vgbn2/BTL-KTVXL-N1/workspace/PROMPT_LOG.md

# Prompt Log

## [2026-10-09T15:35:15.238Z] Session Orchestrator Boot
- Branch: feature/hardware-wiring-and-docs
- Prompt: /session-orchestrator

## [2026-10-10T02:27:55.061Z] Session Orchestrator Boot
- Branch: feature/hardware-wiring-and-docs
- Prompt: /session-orchestrator
