vgbn2/BTL-KTVXL-N1/workspace/handoff/2026/10/2026-10-09.md

# Handoff: 2026-10-09

## Session Summary
- **Accomplishments:**
  1. **Physical Component Alignment:** Cross-checked user's physical order photographs against system models, resolving key physical form-factor discrepancies:
     - W25Q64 Flash module: Modeled as 6-pin breakout board (`[Lập Trình Nhúng A-Z][135]`) with onboard pull-ups on WP# and HOLD#, eliminating unnecessary breadboard jumper wires.
     - ESP32 CH340 DevKit: Updated to 30-Pin Type-C layout, accurately placing UART2 RX2/TX2 (GPIO 16/17) on right header pins 9–10 and VIN on left pin 15.
     - STM32 Blue Pill: Updated to Type-C edition and documented ST-Link V2 SWD programming connection.
     - 2.8" SPI TFT LCD (ILI9341): Re-architected connector as a single contiguous 8-pin straight header matching the physical Red PCB module.
  2. **Automated Verification Probing:** Implemented `scripts/verify_hardware_sim.js` verifying 100% of SVG pin coordinates, dynamic wire net resolutions, and cross-document pin consistency.
  3. **Academic-Grade Engineering Treatise:** Elevated `docs/Hardware_Architecture_and_Wiring_Rationale.md` to an academic-grade report with:
     - Mathematical proof of sampling jitter impact on numerical angle integration ($\sigma_{\delta t} \le 15\text{ }\mu\text{s}$).
     - Analytical proof of display memory ($150\text{ KiB}$) and SPI blocking latency ($61.44\text{ ms}$) demanding dual-MCU partitioning.
     - Signal integrity and rise time calculations for I2C Fast-Mode ($t_r \approx 2.2 R_p C_{\text{bus}}$) and SPI buses (18–40 MHz).
     - Thermal dissipation calculations ($T_J = 46.4^\circ\text{C}$ on ESP32 AMS1117 LDO) and total power budget ($1.17\text{ W}$).
     - Formal FMEA failure matrix with quantitative Risk Priority Numbers (RPN).
  4. **Updated Interactive Studio & Pinouts:** Updated `docs/interactive-wiring.html` and `docs/Wiring_and_Pinouts.md` to achieve 1:1 hardware realism.

- **Files Modified / Created:**
  - `docs/interactive-wiring.html`
  - `docs/Wiring_and_Pinouts.md`
  - `docs/Hardware_Architecture_and_Wiring_Rationale.md`
  - `scripts/verify_hardware_sim.js`
  - `memory/hardware-wiring-architecture.md`
  - `workspace/STATE.md`
  - `workspace/handoff/2026/10/2026-10-09.md`

- **First Next Action:**
  - Implement STM32 bare-metal firmware drivers in `lib/mpu6050` (I2C1 communication, DLPF config, raw reading), `lib/w25qxx` (SPI1 driver, sector erase, write/read calibration data), and Timer ISR (100 Hz Complementary Filter engine).
