vgbn2/BTL-KTVXL-N1/workspace/handoff/2026/10/2026-10-10.md

# Handoff: 2026-10-10

## Session Summary
- **Accomplishments:**
  1. **Documentation Methodology & Predevelopment Package:** Researched the predevelopment research kit and authored the comprehensive 16-section engineering standard in `docs/Project_Predevelopment_Package.md` (967 lines, C4 diagrams, ADRs, state machines, and bidirectional traceability matrix).
  2. **Firmware Core Implementation:** Authored modular C code for sensor fusion (`filter.c`), 15-byte binary telemetry and ASCII command codec (`protocol.c`), W25Q64 Sector 0 serialization with CRC32 (`storage_format.c`), I2C1 MPU6050 driver (`mpu6050.c`), SPI1 flash driver (`w25qxx.c`), and STM32 main loop (`main.c`).
  3. **ESP32 Firmware & Dashboard:** Authored `src/esp32_firmware/esp32_firmware.ino` (ILI9341 320x240 landscape dashboard + UART2 bridge) and verified clean cross-compilation with `arduino-cli`.
  4. **Host Unit Tests & Simulator:** Authored `tests/test_firmware_core.c` and `Makefile`; verified 100% passing tests for filter math, telemetry CRC16, and flash configuration validation.
  5. **Wokwi Simulation Suite:** Created `diagram.json`, `wokwi.toml`, `libraries.txt`, `wokwi_standalone.json`, and standalone 3D interactive simulation sketch `src/esp32_standalone_sim/`.
  6. **Pinout Documentation Enhancement:** Added Section 2.5 ILI9341 2.8" SPI TFT rectangular pinout diagram with left-aligned header pins and right-aligned screen area into `docs/Wiring_and_Pinouts.md`.

- **Verification Evidence:**
  - `make test`: 100% tests passed.
  - `make sim`: STM32 telemetry simulation loop executed cleanly.
  - `arduino-cli compile --fqbn esp32:esp32:esp32 src/esp32_firmware`: 0 errors.
  - `node scripts/verify_hardware_sim.js`: 22 wire nets and 85 pin sockets verified.

- **First Next Action:**
  - Connect physical breadboard wires following `docs/Wiring_and_Pinouts.md`, flash STM32 and ESP32, and execute field calibration.
