vgbn2/BTL-KTVXL-N1/docs/Research/MPU6050.md

# MPU-6050 (GY-521) 6-Axis MotionTracking Module Deep Dive & Register Reference

**Datasheet Reference:** InvenSense *MPU-6000 and MPU-6050 Product Specification*, Document Number `PS-MPU-6000A-00`, Revision 3.4 (08/19/2013).  
**Register Map Reference:** InvenSense *MPU-6000 and MPU-6050 Register Map and Descriptions*, Document Number `RM-MPU-6000A-00`, Revision 4.0 (03/09/2012).  
**Target Hardware:** InvenSense MPU-6050 QFN-24 on GY-521 Breakout Board (Dual Sensor Setup)  
**Target Bus:** Shared I2C1 on STM32F103C8T6 (`PB6` SCL, `PB7` SDA) @ $400\text{ kHz}$ Fast Mode  
**Module Owner (TV1 - Trần Đức Anh):** Driver implementation in `src/lib/drivers/mpu6050.c` & `src/lib/drivers/mpu6050.h`

---

## 1. Physical Pin Layout & Dual-Sensor Hardware Anchoring

### 1.1 GY-521 Breakout Pinout (8-Pin 2.54mm Pitch)

```text
       +-----------------------+
       |   GY-521 (MPU-6050)   |
       |                       |
 [ 1 ] | VCC     (3.3V - 5.0V) | ---> 3.3V System Rail (feeder for onboard LDO)
 [ 2 ] | GND     (0V Ground)   | ---> Common System Ground
 [ 3 ] | SCL     (I2C Clock)   | ---> STM32 PB6 (I2C1_SCL) + 4.7k Pull-up to 3.3V
 [ 4 ] | SDA     (I2C Data)    | ---> STM32 PB7 (I2C1_SDA) + 4.7k Pull-up to 3.3V
 [ 5 ] | XDA     (Aux Data)    | ---> NC (Auxiliary I2C Master pass-through)
 [ 6 ] | XCL     (Aux Clock)   | ---> NC (Auxiliary I2C Master pass-through)
 [ 7 ] | AD0     (Addr Select) | ---> Hardware I2C Address Pin (GND=0x68, 3.3V=0x69)
 [ 8 ] | INT     (Interrupt)   | ---> STM32 EXTI (Optional hardware Data Ready IRQ)
       +-----------------------+
```

### 1.2 Pin Function Descriptions (Datasheet Section 3.2, p. 11)

| Pin | Type | Logic Voltage | Function Description (Datasheet Citations) |
| :--- | :--- | :--- | :--- |
| **`VCC`** | Power Input | $3.3\text{V} - 5.0\text{V}$ | Feeds onboard low-dropout regulator (KB33 / XC6206). Core silicon $V_{\text{DD}}$ operates at $2.375\text{V} - 3.46\text{V}$ (Section 6.3). |
| **`GND`** | Power | $0\text{V}$ | Common system ground return. |
| **`SCL`** | Digital Input | $3.3\text{V}$ | I2C Serial Clock bus. Minimum clock low time $t_{\text{LOW}} \ge 1.3\ \mu\text{s}$, high time $t_{\text{HIGH}} \ge 0.6\ \mu\text{s}$ at $400\text{ kHz}$ Fast Mode (Table 6.4, p. 17). |
| **`SDA`** | Digital I/O | $3.3\text{V}$ (Open-Drain) | I2C Serial Data bus. Requires external $4.7\text{k}\Omega$ pull-up resistor to 3.3V. |
| **`XDA`** | Digital I/O | $3.3\text{V}$ | Auxiliary I2C Master Data line for secondary sensor pass-through (e.g. 3-axis magnetometer HMC5883L / AK8975). |
| **`XCL`** | Digital Output| $3.3\text{V}$ | Auxiliary I2C Master Clock line. |
| **`AD0`** | Digital Input | $0\text{V} - 3.3\text{V}$ | **I2C Address Select (Section 7.5.1):** When tied to GND, 7-bit slave address is `0x68` (`0b1101000`). When tied to 3.3V ($V_{\text{LOGIC}}$), slave address is `0x69` (`0b1101001`). |
| **`INT`** | Digital Output| $3.3\text{V}$ | Programmable interrupt output (Push-pull or Open-drain, Active High or Active Low via `INT_PIN_CFG`). Asserted on Data Ready or Motion Threshold. |

### 1.3 Dual-MPU6050 Hardware Bus Anchoring on Single I2C1

The project utilizes two independent MPU-6050 sensors on the same physical I2C1 bus (`PB6` SCL, `PB7` SDA) without multiplexer hardware:
- **MPU 1 (Primary / Reference IMU):** `AD0` pin soldered to **GND** $\rightarrow$ 7-bit Address = `0x68` (Write: `0xD0`, Read: `0xD1`).
- **MPU 2 (Secondary / Redundancy IMU):** `AD0` pin soldered to **3.3V** $\rightarrow$ 7-bit Address = `0x69` (Write: `0xD2`, Read: `0xD3`).

```text
STM32F103 (I2C1)                   MPU6050 #1 (0x68)              MPU6050 #2 (0x69)
+---------------+                  +---------------+              +---------------+
|               |                  |               |              |               |
|  PB6 (SCL) ---+---+--------------+ SCL           |  +-----------+ SCL           |
|               |   |              |               |  |           |               |
|  PB7 (SDA) ---+---+---+----------+ SDA           |  |  +--------+ SDA           |
|               |   |   |          |               |  |  |        |               |
|  3.3V Rail ---+---|---+--[4.7k]--+ VCC           |  |  |  +-----+ VCC           |
|               |   |   +--[4.7k]--+               |  |  |  |     |               |
|  GND Rail ----+---|--------------+ GND           |  |  |  |     | GND           |
|               |   |              | AD0 ---- GND  |  |  |  |     | AD0 ---- 3.3V |
+---------------+   |              +---------------+  |  |  |     +---------------+
                    |                                 |  |  |
                    +---------------------------------+--+--+
```

---

## 2. Sensor Electrical & Physical Measurement Characteristics

### 2.1 Accelerometer Specifications (Datasheet Table 6.2, p. 14)

| Parameter | Condition | Min | Typical | Max | Unit |
| :--- | :--- | :---: | :---: | :---: | :---: |
| **Full-Scale Range ($AFS\_SEL$)** | Configured via `ACCEL_CONFIG` (Reg 28 / 0x1C) | $\pm 2$, $\pm 4$, $\pm 8$, $\pm 16$ | — | $g$ |
| **Sensitivity Scale Factor** | $\pm 2g$ Range (`AFS_SEL = 0`, Default) | — | **`16,384`** | — | **LSB / g** |
| | $\pm 4g$ Range (`AFS_SEL = 1`) | — | `8,192` | — | LSB / g |
| | $\pm 8g$ Range (`AFS_SEL = 2`) | — | `4,096` | — | LSB / g |
| | $\pm 16g$ Range (`AFS_SEL = 3`) | — | `2,048` | — | LSB / g |
| **Initial Tolerance** | Factory calibration @ $25^\circ\text{C}$ | — | $\pm 50$ | — | mg |
| **Zero-g Output** | X and Y axis | — | $\pm 50$ | — | mg |
| | Z axis (including gravity) | — | $\pm 80$ | — | mg |
| **Non-Linearity** | Best fit straight line | — | $\pm 0.5$ | — | % |
| **Cross-Axis Sensitivity** | Cross-axis alignment | — | $\pm 2$ | — | % |
| **Noise Power Spectral Density** | Low noise mode @ 10 Hz | — | $400$ | — | $\mu g / \sqrt{\text{Hz}}$ |

### 2.2 Gyroscope Specifications (Datasheet Table 6.1, p. 13)

| Parameter | Condition | Min | Typical | Max | Unit |
| :--- | :--- | :---: | :---: | :---: | :---: |
| **Full-Scale Range ($FS\_SEL$)** | Configured via `GYRO_CONFIG` (Reg 27 / 0x1B) | $\pm 250$, $\pm 500$, $\pm 1000$, $\pm 2000$ | — | $^\circ/\text{s}$ (dps) |
| **Sensitivity Scale Factor** | $\pm 250^\circ/\text{s}$ Range (`FS_SEL = 0`, Default) | — | **`131.0`** | — | **LSB / (dps)** |
| | $\pm 500^\circ/\text{s}$ Range (`FS_SEL = 1`) | — | `65.5` | — | LSB / (dps) |
| | $\pm 1000^\circ/\text{s}$ Range (`FS_SEL = 2`) | — | `32.8` | — | LSB / (dps) |
| | $\pm 2000^\circ/\text{s}$ Range (`FS_SEL = 3`) | — | `16.4` | — | LSB / (dps) |
| **Zero-Rate Output (ZRO)** | $25^\circ\text{C}$, stationary | — | $\pm 20$ | — | $^\circ/\text{s}$ |
| **Total RMS Noise** | DLPF = 42 Hz | — | $0.05$ | — | $^\circ/\text{s-rms}$ |
| **Non-Linearity** | Best fit straight line | — | $0.2$ | — | % |

---

## 3. Register Map and Bitfield Definitions (Extracted from RM-MPU-6000A Rev 4.0)

All internal registers are memory-mapped 8-bit locations accessible via I2C read and write operations.

### 3.1 Primary Register Table (Section 3, pp. 6–8)

| Reg (Hex) | Reg (Dec) | Register Name | R/W | Bitfield Layout | Reset Val | Function Description |
| :---: | :---: | :--- | :---: | :--- | :---: | :--- |
| **`0x19`** | 25 | `SMPLRT_DIV` | R/W | `SMPLRT_DIV[7:0]` | `0x00` | Sample Rate Divider: $\text{Rate} = \frac{\text{Gyro Output Rate}}{1 + \text{SMPLRT\_DIV}}$. |
| **`0x1A`** | 26 | `CONFIG` | R/W | `-[7:6], EXT_SYNC_SET[5:3], DLPF_CFG[2:0]` | `0x00` | Digital Low Pass Filter and external FSYNC configuration. |
| **`0x1B`** | 27 | `GYRO_CONFIG` | R/W | `XG_ST[7], YG_ST[6], ZG_ST[5], FS_SEL[4:3], -[2:0]` | `0x00` | Gyroscope self-test enable and full-scale range select. |
| **`0x1C`** | 28 | `ACCEL_CONFIG` | R/W | `XA_ST[7], YA_ST[6], ZA_ST[5], AFS_SEL[4:3], -[2:0]` | `0x00` | Accelerometer self-test enable and full-scale range select. |
| **`0x23`** | 35 | `FIFO_EN` | R/W | `TEMP_FIFO_EN[7], XG_FIFO_EN[6], YG_FIFO_EN[5], ZG_FIFO_EN[4], ACCEL_FIFO_EN[3], SLV2_FIFO_EN[2], SLV1_FIFO_EN[1], SLV0_FIFO_EN[0]` | `0x00` | Enables routing of sensor data into the 1024-byte FIFO buffer. |
| **`0x37`** | 55 | `INT_PIN_CFG` | R/W | `INT_LEVEL[7], INT_OPEN[6], LATCH_INT_EN[5], INT_RD_CLEAR[4], FSYNC_INT_LEVEL[3], FSYNC_INT_EN[2], I2C_BYPASS_EN[1], -[0]` | `0x00` | Interrupt pin active level, open-drain/push-pull, latching, and I2C bypass. |
| **`0x38`** | 56 | `INT_ENABLE` | R/W | `-[7:5], FIFO_OFLOW_EN[4], I2C_MST_INT_EN[3], -[2:1], DATA_RDY_EN[0]` | `0x00` | Interrupt source generation enables (`DATA_RDY_EN = 1` enables Data Ready). |
| **`0x3A`** | 58 | `INT_STATUS` | R | `-[7:5], FIFO_OFLOW_INT[4], I2C_MST_INT[3], -[2:1], DATA_RDY_INT[0]` | `0x00` | Interrupt status bits (cleared automatically upon reading). |
| **`0x3B`** | 59 | `ACCEL_XOUT_H` | R | `ACCEL_X[15:8]` | Data | Accelerometer X-axis measurement high byte (Start of 14-byte burst read). |
| **`0x3C`** | 60 | `ACCEL_XOUT_L` | R | `ACCEL_X[7:0]` | Data | Accelerometer X-axis measurement low byte. |
| **`0x3D`** | 61 | `ACCEL_YOUT_H` | R | `ACCEL_Y[15:8]` | Data | Accelerometer Y-axis measurement high byte. |
| **`0x3E`** | 62 | `ACCEL_YOUT_L` | R | `ACCEL_Y[7:0]` | Data | Accelerometer Y-axis measurement low byte. |
| **`0x3F`** | 63 | `ACCEL_ZOUT_H` | R | `ACCEL_Z[15:8]` | Data | Accelerometer Z-axis measurement high byte. |
| **`0x40`** | 64 | `ACCEL_ZOUT_L` | R | `ACCEL_Z[7:0]` | Data | Accelerometer Z-axis measurement low byte. |
| **`0x41`** | 65 | `TEMP_OUT_H` | R | `TEMP[15:8]` | Data | Temperature sensor measurement high byte. |
| **`0x42`** | 66 | `TEMP_OUT_L` | R | `TEMP[7:0]` | Data | Temperature sensor measurement low byte ($T = \frac{\text{Raw}}{340} + 36.53$). |
| **`0x43`** | 67 | `GYRO_XOUT_H` | R | `GYRO_X[15:8]` | Data | Gyroscope X-axis measurement high byte. |
| **`0x44`** | 68 | `GYRO_XOUT_L` | R | `GYRO_X[7:0]` | Data | Gyroscope X-axis measurement low byte. |
| **`0x45`** | 69 | `GYRO_YOUT_H` | R | `GYRO_Y[15:8]` | Data | Gyroscope Y-axis measurement high byte. |
| **`0x46`** | 70 | `GYRO_YOUT_L` | R | `GYRO_Y[7:0]` | Data | Gyroscope Y-axis measurement low byte. |
| **`0x47`** | 71 | `GYRO_ZOUT_H` | R | `GYRO_Z[15:8]` | Data | Gyroscope Z-axis measurement high byte. |
| **`0x48`** | 72 | `GYRO_ZOUT_L` | R | `GYRO_Z[7:0]` | Data | Gyroscope Z-axis measurement low byte (End of 14-byte burst read). |
| **`0x6A`** | 106 | `USER_CTRL` | R/W | `-[7], FIFO_EN[6], I2C_MST_EN[5], I2C_IF_DIS[4], -[3], FIFO_RESET[2], I2C_MST_RESET[1], SIG_COND_RESET[0]` | `0x00` | Enable/reset FIFO, secondary I2C master, and signal conditioning blocks. |
| **`0x6B`** | 107 | `PWR_MGMT_1` | R/W | `DEVICE_RESET[7], SLEEP[6], CYCLE[5], -[4], TEMP_DIS[3], CLKSEL[2:0]` | **`0x40`** | **Silicon boots in SLEEP (`0x40`). Must write `0x01` to wake and select PLL clock.** |
| **`0x6C`** | 108 | `PWR_MGMT_2` | R/W | `LP_WAKE_CTRL[7:6], STBY_XA[5], STBY_YA[4], STBY_ZA[3], STBY_XG[2], STBY_YG[1], STBY_ZG[0]` | `0x00` | Low-power accelerometer wake frequency and individual axis standby control. |
| **`0x72`** | 114 | `FIFO_COUNTH` | R | `FIFO_COUNT[15:8]` | `0x00` | Current number of bytes written in FIFO (High byte). |
| **`0x73`** | 115 | `FIFO_COUNTL` | R | `FIFO_COUNT[7:0]` | `0x00` | Current number of bytes written in FIFO (Low byte). |
| **`0x74`** | 116 | `FIFO_R_W` | R/W | `FIFO_DATA[7:0]` | `0x00` | FIFO read/write port. |
| **`0x75`** | 117 | `WHO_AM_I` | R | `-[7], WHO_AM_I[6:1], -[0]` | **`0x68`** | Silicon 6-bit identity verification. Must equal `0x68` (or `0x70` for MPU-6500). |

---

## 4. Deep-Dive Extraction of Key Functional Registers

### 4.1 Sample Rate Calculation & SMPLRT_DIV (Section 4.2, p. 11)

The internal sensor sample rate is configured via Register 25 (`0x19`):

$$\text{Sample Rate} = \frac{\text{Gyroscope Output Rate}}{1 + \text{SMPLRT\_DIV}}$$

- When DLPF is **disabled** (`DLPF_CFG = 0` or `7` in Register 26): Gyroscope Output Rate = **$8\text{ kHz}$**.
- When DLPF is **enabled** (`DLPF_CFG = 1` through `6`): Gyroscope Output Rate = **$1\text{ kHz}$**.

**Project Timing Anchor:**  
With DLPF configured to `0x03` ($1\text{ kHz}$ base rate):
- Setting `SMPLRT_DIV = 0x09` ($9_{\text{dec}}$) yields:
  $$\text{Sample Rate} = \frac{1000\text{ Hz}}{1 + 9} = 100\text{ Hz}\quad (10.0\text{ ms period})$$
  This precisely synchronizes with the system timer interrupt defined in `docs/QUY_TAC_CODE_NHOM_MPU6050.md` (`IMU_SAMPLE_RATE_HZ = 100`, $dt = 0.01\text{ s}$).
- Setting `SMPLRT_DIV = 0x19` ($25_{\text{dec}}$) yields:
  $$\text{Sample Rate} = \frac{1000\text{ Hz}}{1 + 25} \approx 38.46\text{ Hz}$$

---

### 4.2 Digital Low Pass Filter (DLPF_CFG) Mechanics (Section 4.3, p. 13)

Register 26 (`0x1A` / `CONFIG`) bits `[2:0]` configure the on-chip analog-to-digital converter (ADC) digital filter pipeline for both Accelerometer and Gyroscope signals:

| DLPF_CFG | Accelerometer Bandwidth (Hz) | Accelerometer Delay (ms) | Gyroscope Bandwidth (Hz) | Gyroscope Delay (ms) | Fs (kHz) |
| :---: | :---: | :---: | :---: | :---: | :---: |
| **`0`** | 260 | 0.0 | 256 | 0.98 | 8 |
| **`1`** | 184 | 2.0 | 188 | 1.9 | 1 |
| **`2`** | 94 | 3.0 | 98 | 2.8 | 1 |
| **`3`** | **44** | **4.9** | **42** | **4.8** | **1** |
| **`4`** | 21 | 8.5 | 20 | 8.3 | 1 |
| **`5`** | 10 | 13.8 | 10 | 13.4 | 1 |
| **`6`** | 5 | 19.0 | 5 | 18.6 | 1 |
| **`7`** | RESERVED | RESERVED | RESERVED | RESERVED | 8 |

**Design Choice (`DLPF_CFG = 0x03`):**  
Bandwidth of $44\text{ Hz}$ on accelerometer and $42\text{ Hz}$ on gyroscope attenuates high-frequency motor vibration and chassis resonance (>50 Hz) while introducing only $\approx 4.8\text{ ms}$ of group delay, well within our $10\text{ ms}$ ($100\text{ Hz}$) control loop deadline.

---

### 4.3 Full-Scale Range Configuration (GYRO_CONFIG & ACCEL_CONFIG)

#### Gyroscope Full-Scale Selection (`FS_SEL`, Section 4.4, p. 14)

Register 27 (`0x1B`): bits `[4:3]` configure full-scale sensitivity:

| FS_SEL[1:0] | Full-Scale Range | Sensitivity Scale Factor | LSB Sensitivity |
| :---: | :---: | :---: | :---: |
| **`0` (`0x00`)** | **$\pm 250^\circ/\text{s}$** | **$131.0\text{ LSB} / (^\circ/\text{s})$** | **$0.007633^\circ/\text{s} / \text{LSB}$** |
| **`1` (`0x08`)** | $\pm 500^\circ/\text{s}$ | $65.5\text{ LSB} / (^\circ/\text{s})$ | $0.015267^\circ/\text{s} / \text{LSB}$ |
| **`2` (`0x10`)** | $\pm 1000^\circ/\text{s}$ | $32.8\text{ LSB} / (^\circ/\text{s})$ | $0.030488^\circ/\text{s} / \text{LSB}$ |
| **`3` (`0x18`)** | $\pm 2000^\circ/\text{s}$ | $16.4\text{ LSB} / (^\circ/\text{s})$ | $0.060976^\circ/\text{s} / \text{LSB}$ |

#### Accelerometer Full-Scale Selection (`AFS_SEL`, Section 4.5, p. 15)

Register 28 (`0x1C`): bits `[4:3]` configure full-scale sensitivity:

| AFS_SEL[1:0] | Full-Scale Range | Sensitivity Scale Factor | LSB Sensitivity |
| :---: | :---: | :---: | :---: |
| **`0` (`0x00`)** | **$\pm 2g$** | **$16,384\text{ LSB} / g$** | **$0.061035\text{ mg} / \text{LSB}$** |
| **`1` (`0x08`)** | $\pm 4g$ | $8,192\text{ LSB} / g$ | $0.122070\text{ mg} / \text{LSB}$ |
| **`2` (`0x10`)** | $\pm 8g$ | $4,096\text{ LSB} / g$ | $0.244141\text{ mg} / \text{LSB}$ |
| **`3` (`0x18`)** | $\pm 16g$ | $2,048\text{ LSB} / g$ | $0.488281\text{ mg} / \text{LSB}$ |

---

### 4.4 Shadow Registers & Atomic 14-Byte Burst Read Mechanism (Section 4.18, p. 30)

A critical architectural feature detailed in Section 4.18 of `RM-MPU-6000A` is the **User-Facing Read Buffer** (shadow register architecture):

```text
+---------------------------------------------------------------------------------+
|                       INTERNAL SENSOR SAMPLE PIPELINE                            |
|  [ADC / DLPF Engine] ---> Updates Internal Holding Registers @ Sample Rate (1kHz) |
+---------------------------------------------------------------------------------+
                                        |
                 Updated only when I2C bus is IDLE or at START condition
                                        v
+---------------------------------------------------------------------------------+
|                       USER-FACING SHADOW REGISTERS                               |
|  0x3B (ACCEL_X_H) .. 0x40 (ACCEL_Z_L) | 0x41..0x42 (TEMP) | 0x43..0x48 (GYRO_Z_L)|
+---------------------------------------------------------------------------------+
                                        ^
                                        | Read atomically via I2C Auto-Increment
+---------------------------------------------------------------------------------+
| STM32 Master: Single 14-Byte Burst Read Transaction starting at Reg 0x3B         |
+---------------------------------------------------------------------------------+
```

**Hardware Invariant:**  
> *"The most recent record is stored in a set of registers which are user-facing read registers. These registers are updated with the value of the internal registers when the serial interface is idle. If the user reads an accelerometer data register and that data register is subsequently updated with new data, the read value will not be affected."* (RM-MPU-6000A Section 4.18)

**Why Individual Byte Reads Fail:**  
If a driver reads high byte `ACCEL_XOUT_H` and low byte `ACCEL_XOUT_L` in separate I2C transactions, an internal ADC sample clock edge occurring between the two reads can cause MSB/LSB tearing (e.g., transition from `0x00FF` to `0x0100` read as `0x0000` or `0x01FF`).  
**Driver Implementation Rule:**  
Always issue an atomic 14-byte sequential burst read starting at register `0x3B`:
```c
uint8_t raw[14];
HAL_I2C_Mem_Read(&hi2c1, (dev_addr << 1), 0x3B, 1, raw, 14, 50);
```

---

### 4.5 Temperature Sensor Formula & Characteristics (Section 4.19, p. 31)

Registers 65 and 66 (`0x41` and `0x42`) provide a 16-bit signed measurement of silicon die temperature.

#### Transfer Function:

$$\text{Temperature in } ^\circ\text{C} = \frac{\text{TEMP\_OUT}}{340} + 36.53$$

- **Zero-Reading Point:** $\text{TEMP\_OUT} = 0 \implies T = 36.53^\circ\text{C}$.
- **Sensitivity:** $340\text{ LSB} / ^\circ\text{C}$.
- **Linear Range:** $-40^\circ\text{C} \text{ to } +85^\circ\text{C}$.

---

### 4.6 Power Management 1 & Clock Selection (Section 4.30, p. 41)

Register 107 (`0x6B` / `PWR_MGMT_1`):

| Bit | Bit Name | Reset | Description |
| :---: | :--- | :---: | :--- |
| **7** | `DEVICE_RESET` | 0 | Writing `1` resets all internal registers to default. Self-clearing bit. |
| **6** | `SLEEP` | **1** | Silicon boots into low-power sleep mode by default (`0x40`). Must write `0` to wake! |
| **5** | `CYCLE` | 0 | Cycle mode: sleeps and wakes up at rate set by `LP_WAKE_CTRL`. |
| **4** | Reserved | 0 | Reserved. |
| **3** | `TEMP_DIS` | 0 | Writing `1` disables the internal temperature sensor. |
| **[2:0]**| `CLKSEL[2:0]` | 000 | Clock source selection (see table below). |

#### Clock Source Selection Table (`CLKSEL`):

| CLKSEL | Clock Source Description | Recommended Usage |
| :---: | :--- | :--- |
| **`0`** | Internal 8 MHz oscillator | Default at boot; prone to thermal drift ($\pm 5\%$). |
| **`1`** | **PLL with X-axis gyroscope reference** | **Highly Recommended:** Ultra-stable crystal-derived gyro clock. |
| **`2`** | PLL with Y-axis gyroscope reference | Stable crystal reference. |
| **`3`** | PLL with Z-axis gyroscope reference | Stable crystal reference. |
| **`4`** | PLL with external 32.768 kHz reference | Requires external clock source on CLKIN pin. |
| **`5`** | PLL with external 19.2 MHz reference | Requires external clock source on CLKIN pin. |
| **`6`** | Reserved | Do not use. |
| **`7`** | Stops clock generator (Reset state) | Timing generator held in reset. |

**Bring-Up Invariant:**  
Always write `0x01` to `PWR_MGMT_1` during initialization: wakes the chip from sleep (`SLEEP=0`) and locks PLL to the X-axis gyroscope oscillator (`CLKSEL=1`).

---

### 4.7 Power Management 2 & Low-Power Wake Control (Section 4.31, p. 43)

Register 108 (`0x6C` / `PWR_MGMT_2`):
- `LP_WAKE_CTRL[7:6]`: Controls accelerometer wake-up frequency in low-power cycle mode:
  - `00`: $1.25\text{ Hz}$
  - `01`: $5\text{ Hz}$
  - `10`: $20\text{ Hz}$
  - `11`: $40\text{ Hz}$
- `STBY_XA, STBY_YA, STBY_ZA`: Individual standby disable for accelerometer axes.
- `STBY_XG, STBY_YG, STBY_ZG`: Individual standby disable for gyroscope axes.

---

### 4.8 Identity Verification Register (WHO_AM_I, Section 4.34, p. 46)

Register 117 (`0x75` / `WHO_AM_I`):
- Bits `[6:1]` hold the upper 6 bits of the 7-bit default I2C address: `0b110100` (`0x68`).
- Bits `[7]` and `[0]` are reserved and read as `0`.
- Expected return on authentic MPU-6050: **`0x68`**.
- MPU-6500 variant return: **`0x70`**.
- InvenSense clone/variant return: **`0x72`**.

---

## 5. Dual-Sensor I2C Communication Sequences

### 5.1 Device Wake-Up & Configuration Sequence

```text
Master: [START] -> [ADDR+W (0xD0/0xD2)] -> [ACK] -> [0x6B (PWR_MGMT_1)] -> [ACK] -> [0x80 (RESET)] -> [ACK] -> [STOP]
(Wait 100 ms for analog LDO & charge pump stabilization)
Master: [START] -> [ADDR+W (0xD0/0xD2)] -> [ACK] -> [0x6B (PWR_MGMT_1)] -> [ACK] -> [0x01 (CLKSEL=X-Gyro)] -> [ACK] -> [STOP]
(Wait 10 ms for PLL lock)
Master: [START] -> [ADDR+W (0xD0/0xD2)] -> [ACK] -> [0x19 (SMPLRT_DIV)]  -> [ACK] -> [0x19 (DIV=25)] -> [ACK] -> [STOP]
Master: [START] -> [ADDR+W (0xD0/0xD2)] -> [ACK] -> [0x1A (CONFIG)]      -> [ACK] -> [0x03 (DLPF=44Hz)] -> [ACK] -> [STOP]
Master: [START] -> [ADDR+W (0xD0/0xD2)] -> [ACK] -> [0x1C (ACCEL_CFG)]  -> [ACK] -> [0x00 (±2g)]     -> [ACK] -> [STOP]
Master: [START] -> [ADDR+W (0xD0/0xD2)] -> [ACK] -> [0x1B (GYRO_CFG)]   -> [ACK] -> [0x00 (±250dps)] -> [ACK] -> [STOP]
Master: [START] -> [ADDR+W (0xD0/0xD2)] -> [ACK] -> [0x38 (INT_ENABLE)]  -> [ACK] -> [0x01 (DATA_RDY)] -> [ACK] -> [STOP]
```

### 5.2 Atomic 14-Byte Burst Read Sequence

```text
Master: [START] -> [ADDR+W (0xD0/0xD2)] -> [ACK] -> [0x3B (ACCEL_XOUT_H)] -> [ACK]
Master: [REPEATED START] -> [ADDR+R (0xD1/0xD3)] -> [ACK]
Slave:  [Byte 0:  ACCEL_X_H] -> Master [ACK]
Slave:  [Byte 1:  ACCEL_X_L] -> Master [ACK]
Slave:  [Byte 2:  ACCEL_Y_H] -> Master [ACK]
Slave:  [Byte 3:  ACCEL_Y_L] -> Master [ACK]
Slave:  [Byte 4:  ACCEL_Z_H] -> Master [ACK]
Slave:  [Byte 5:  ACCEL_Z_L] -> Master [ACK]
Slave:  [Byte 6:  TEMP_H]    -> Master [ACK]
Slave:  [Byte 7:  TEMP_L]    -> Master [ACK]
Slave:  [Byte 8:  GYRO_X_H]  -> Master [ACK]
Slave:  [Byte 9:  GYRO_X_L]  -> Master [ACK]
Slave:  [Byte 10: GYRO_Y_H]  -> Master [ACK]
Slave:  [Byte 11: GYRO_Y_L]  -> Master [ACK]
Slave:  [Byte 12: GYRO_Z_H]  -> Master [ACK]
Slave:  [Byte 13: GYRO_Z_L]  -> Master [NACK] -> Master [STOP]
```

---

## 6. Mathematical Tilt Estimation & Complementary Filter Pipeline

### 6.1 Theoretical Basis (MEMS Accelerometer vs Gyroscope)

- **Accelerometer:** Measures the net acceleration vector $\vec{a} = \vec{a}_{\text{dynamic}} - \vec{g}$. In quasi-static conditions ($\vec{a}_{\text{dynamic}} \approx 0$), it provides an absolute, drift-free gravity reference vector, but is highly sensitive to external mechanical vibrations and shock noise.
- **Gyroscope:** Measures body angular rotation rate $\vec{\omega}$. Integrating $\vec{\omega} \cdot \Delta t$ provides smooth, instantaneous high-frequency angle changes immune to linear vibrations, but accumulates DC sensor bias into unbounded integration drift over time.

### 6.2 Accelerometer Angle Calculations (Team Standard: TV3 / TV1)

In accordance with Section 4 of `docs/QUY_TAC_CODE_NHOM_MPU6050.md`:

#### Roll ($\theta_{\text{roll}}$, rotation around X-axis):
$$\text{acc\_roll\_deg} = \text{atan2f}(a_y, a_z) \times \frac{180.0}{\pi}$$

#### Pitch ($\theta_{\text{pitch}}$, rotation around Y-axis):
$$\text{acc\_pitch\_deg} = \text{atan2f}\left(-a_x, \sqrt{a_y^2 + a_z^2}\right) \times \frac{180.0}{\pi}$$

### 6.3 Discrete-Time Complementary Filter Equation

Combining the high-pass filtered gyro integration with the low-pass filtered accelerometer reference:

$$\theta_{\text{roll}}(k) = \alpha \cdot \left(\theta_{\text{roll}}(k-1) + g_x \cdot \Delta t\right) + (1.0 - \alpha) \cdot \text{acc\_roll\_deg}(k)$$

$$\theta_{\text{pitch}}(k) = \alpha \cdot \left(\theta_{\text{pitch}}(k-1) + g_y \cdot \Delta t\right) + (1.0 - \alpha) \cdot \text{acc\_pitch\_deg}(k)$$

- $\Delta t = 0.01\text{ s}$ ($100\text{ Hz}$ sample period from STM32 Timer).
- $\alpha = 0.98$ (Default filter constant, tunable via UART `SET_FILTER_ALPHA:0.98` between $0.50$ and $0.999$).
- Cutoff frequency:
  $$f_c = \frac{1 - \alpha}{2 \pi \alpha \Delta t} = \frac{1 - 0.98}{2 \pi \times 0.98 \times 0.01} \approx 0.325\text{ Hz}$$

---

## 7. C Driver Implementation (TV1 - Trần Đức Anh)

The driver source files (`src/lib/drivers/mpu6050.h` and `src/lib/drivers/mpu6050.c`) satisfy 100% of the team API contract while adding seamless dual-sensor support.

### 7.1 Public API Signatures (`src/lib/drivers/mpu6050.h`)

```c
/* --- Team Standard Public API (TV1: Tran Duc Anh) --- */
int MPU6050_Init(void);
int MPU6050_Read(IMU_Data_t *data);
bool MPU6050_CheckConnection(void);
int MPU6050_ReadData(MPU6050_DATA *imu);

/* --- Dual-Sensor Extension API (0x68 and 0x69) --- */
int MPU6050_InitDevice(uint8_t i2c_addr);
int MPU6050_ReadDevice(uint8_t i2c_addr, IMU_Data_t *data);
bool MPU6050_CheckConnectionDevice(uint8_t i2c_addr);
int MPU6050_ReadRawDevice(uint8_t i2c_addr, MPU6050_DATA *imu);
int MPU6050_InitDual(void);
int MPU6050_ReadDual(IMU_Data_t *data1, IMU_Data_t *data2);
```

### 7.2 Sensitivity Conversions

```c
#define MPU6050_ACCELEROMETER_SENSITIVITY   16384.0f    /* ±2g range: LSB / g */
#define MPU6050_GYRO_SENSITIVITY            131.0f      /* ±250 dps range: LSB / dps */

/* Conversion in MPU6050_ReadDevice */
data->ax_g   = (float)raw_ax / MPU6050_ACCELEROMETER_SENSITIVITY;
data->ay_g   = (float)raw_ay / MPU6050_ACCELEROMETER_SENSITIVITY;
data->az_g   = (float)raw_az / MPU6050_ACCELEROMETER_SENSITIVITY;

data->gx_dps = (float)raw_gx / MPU6050_GYRO_SENSITIVITY;
data->gy_dps = (float)raw_gy / MPU6050_GYRO_SENSITIVITY;
data->gz_dps = (float)raw_gz / MPU6050_GYRO_SENSITIVITY;
```
