vgbn2/BTL-KTVXL-N1/docs/interactive-wiring.html

# Interactive Breadboard Wiring Studio — Move & Rotate Canvas

Drag & drop components, rotate 90°, zoom/pan canvas — Wires stay dynamically attached in real-time

Reset Canvas View Breadboard Layout Preset Schematic Flow Preset

Bus Filter: All Wires I2C1 (GY-521) SPI1 (W25Qxx) VSPI (2.8" TFT) UART Bridge 5V / 3.3V / GND

Zoom & Canvas: + − Rotate Selected (90°)

Interactive Circuit Board View (Drag modules to move • Click to select • Scroll to zoom) 17 Dynamic Wires Active

Component Manager NONE SELECTED

Click a module to select

Pin & Signal Inspector INSPECT

Component:STM32 Blue Pill

Pin:PB6 (SCL1)

Function:I2C1 SCL

Voltage:3.3V (5V-FT)

Hardware I2C clock line connected to GY-521 (MPU6050) SCL.

Live Sensor & Screen Preview 100 Hz

ESP32 + ILI9341 DISPLAY

ROLL: +12.4°

PITCH: -5.8°

UART: ACTIVE @ 115200 BAUD

Simulate Roll Angle+12.4°

Simulate Pitch Angle-5.8°
