vgbn2/BTL-KTVXL-N1/(commit log)

2026-10-09 docs: add interactive wiring studio, pinouts, and hardware architecture rationale
2026-10-10 feat(firmware,docs): implement dual-MCU tilt measurement firmware, predev package, and Wokwi simulation
    - Author 16-section predevelopment package in docs/Project_Predevelopment_Package.md with C4 models, ADRs, state machines, and traceability matrix
    - Implement STM32 core drivers (MPU6050 I2C1, W25Q64 SPI1, 100Hz Complementary filter, USART1 binary telemetry frame & ASCII codec)
    - Implement ESP32 ILI9341 320x240 dashboard, digital readouts, horizon indicator, and UART2 command bridge
    - Add host-runnable C unit test suite (tests/test_firmware_core.c) and simulation targets in Makefile
    - Add Wokwi simulation configurations (diagram.json, wokwi.toml, wokwi_standalone.json, libraries.txt)
    - Upd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
2026-11-10 feat(firmware,ci): publish single-MCU STM32F103 build, offline CI, and serial tools
2026-11-10 fix(ci): direct py_compile cache outside repo before UART self-test
2026-11-10 fix(uart,scripts,docs): add deferred TX echo and raw PuTTY line editing
2026-11-10 sync(drivers,build): sync upstream drivers and align file tree with manual positions
    - Move uart_cmd to src/lib/drivers/ and system_time to src/lib/shared/
    - Relocate mock test harnesses to tests/mocks/ keeping tests intact
    - Prune un-existed non-upstream files from src/
    - Copy drivers directly from BTLVXL-Nhóm 1/USER/
    - Enable -u _printf_float in FIRMWARE_LDFLAGS for float telemetry (fixes #3)
    - Support terminal monitoring on make flash and make monitor (fixes #4)
    - Accept Flash JEDEC 0x204016 in diagnostic tests (fixes #5)
    - Reconcile PB10/PB11 documentation across pinouts (fixes #6)
    - Keep production Flash/UART paths in host boundary and contract tests (fixes #1, #2)
2026-11-10 feat(uart): allow configurable baud rate via source define and make BAUD override
2026-11-10 feat(test-hw): add make test-hw target for live physical sensor and bus verification
